stephenangelico/time-on-target/Diagrams/Time_On_Target_Diagram.png

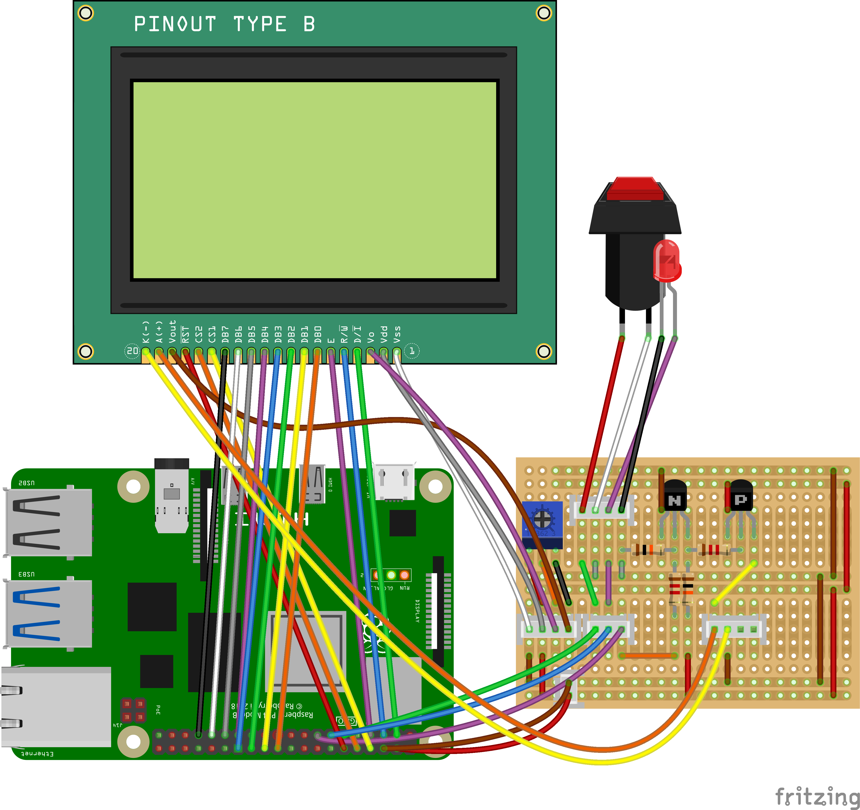
Diagrams/Time_On_Target_Diagram.png
