stephenangelico/time-on-target/Diagrams/Time_On_Target_Schematic.png

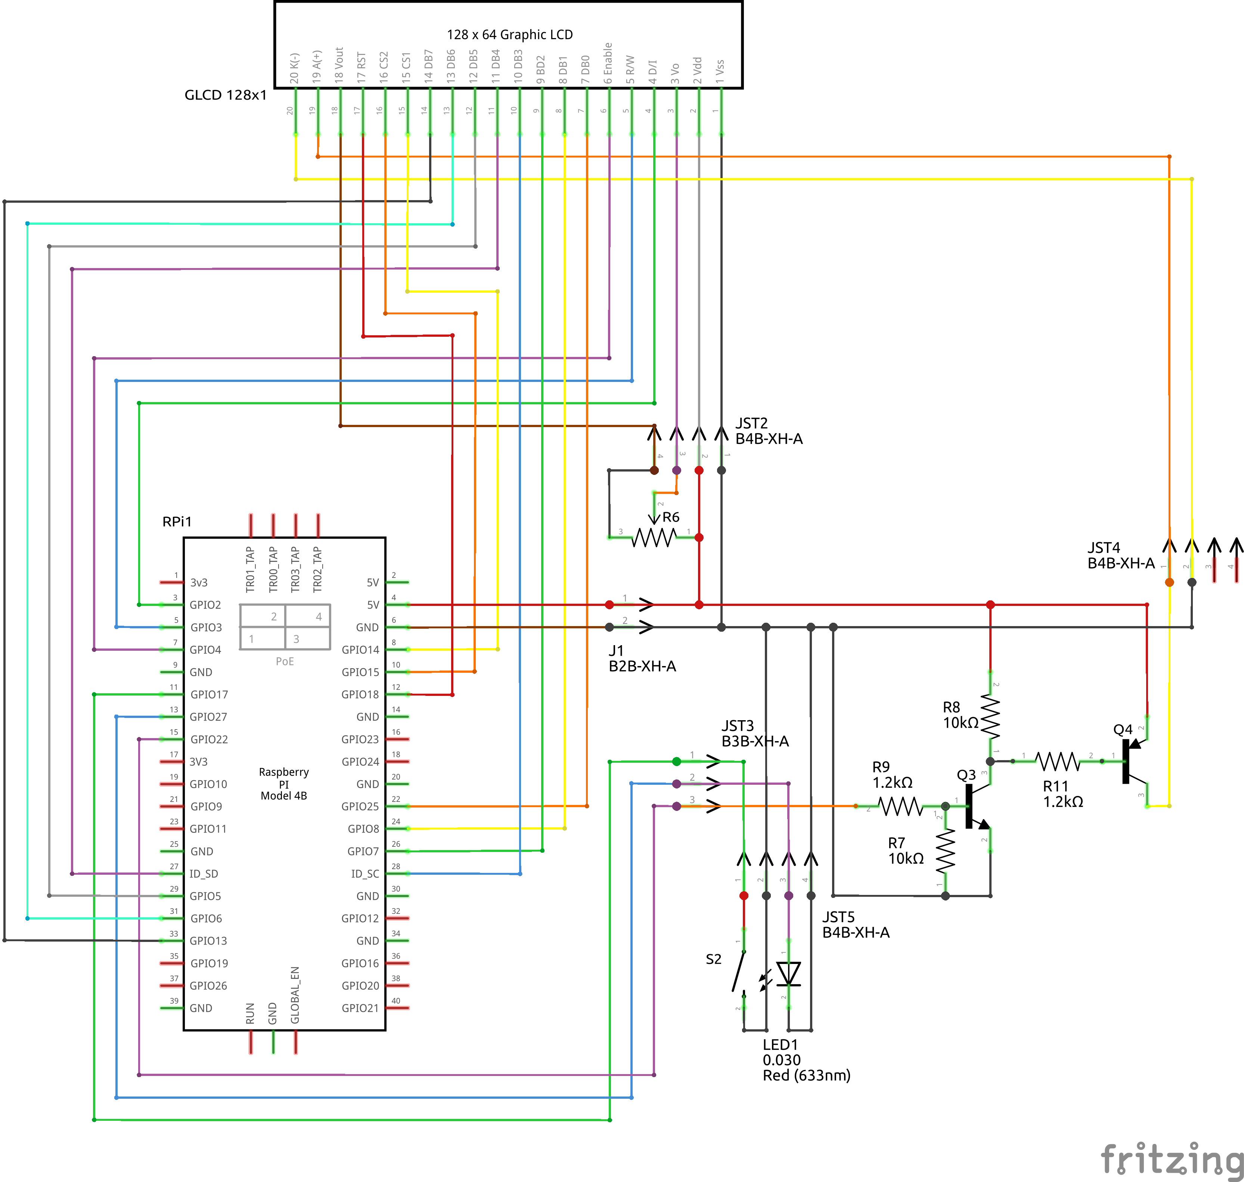
Diagrams/Time_On_Target_Schematic.png
