stephenangelico/time-on-target/Diagrams/TOT_Diagram.png

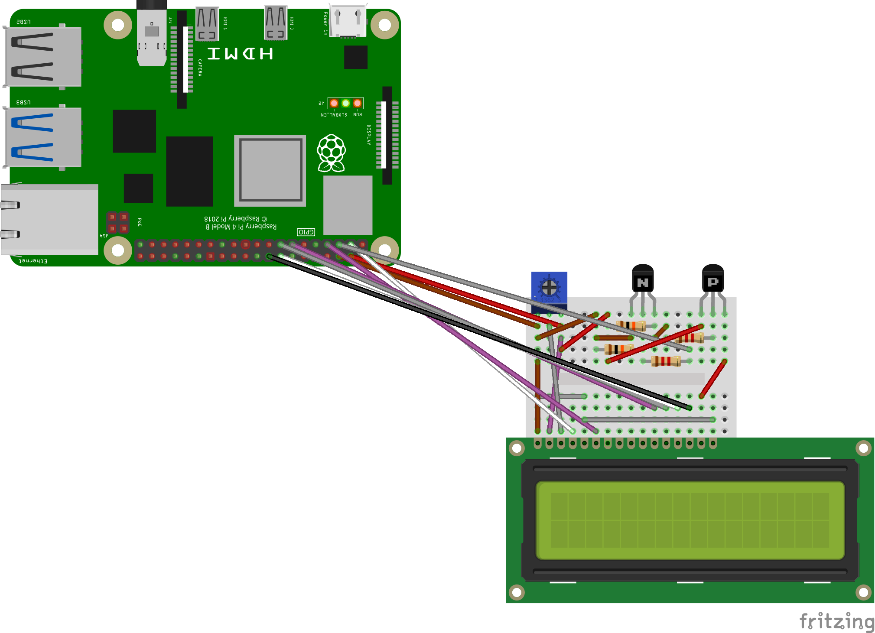
Diagrams/TOT_Diagram.png
