stephenangelico/time-on-target/Diagrams/TOT_Diagram_Matrix_Display.png

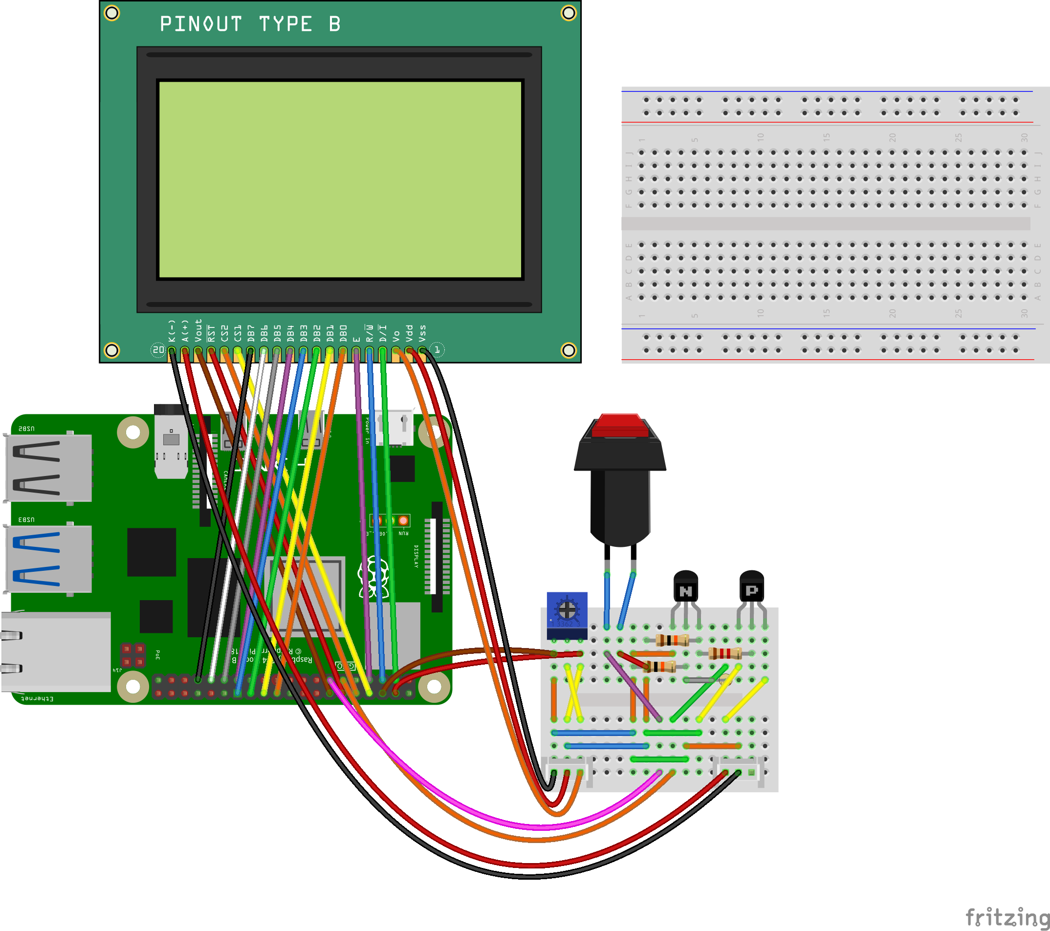
Diagrams/TOT_Diagram_Matrix_Display.png
