stephenangelico/time-on-target/Diagrams/Time_On_Target_Schematic.pdf

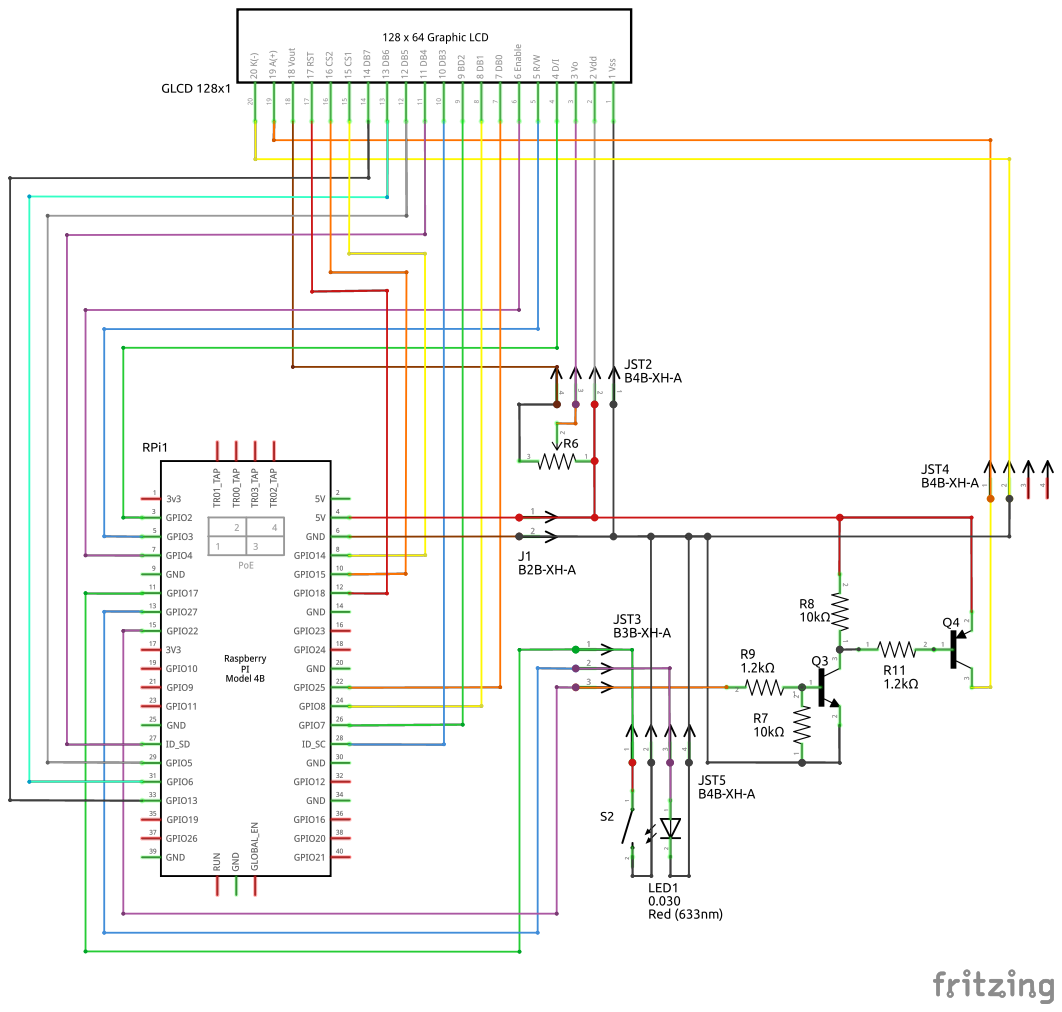
[picture p5: page 1]
