stephenangelico/time-on-target/Diagrams/Matrix_Display_schematic.pdf

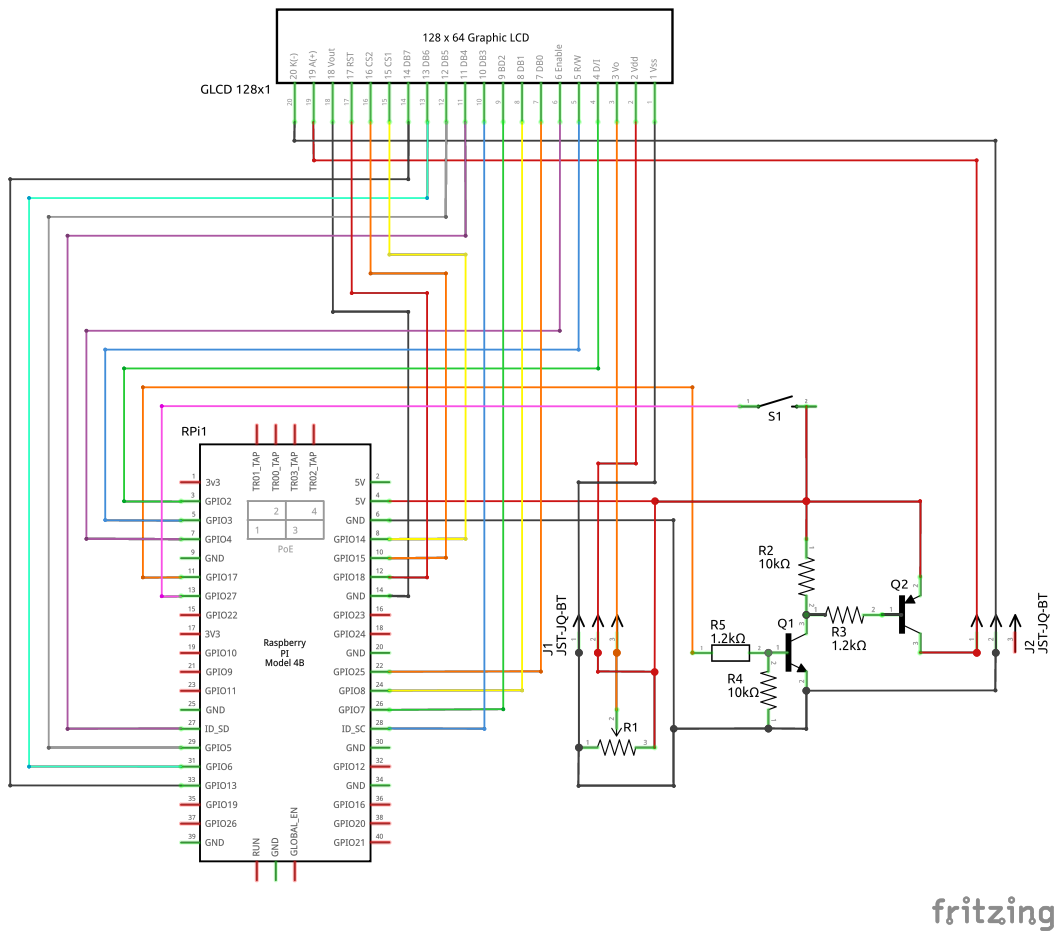
[picture p6: page 1]
