stephenangelico/time-on-target/Diagrams/Time_On_Target_Diagram.pdf

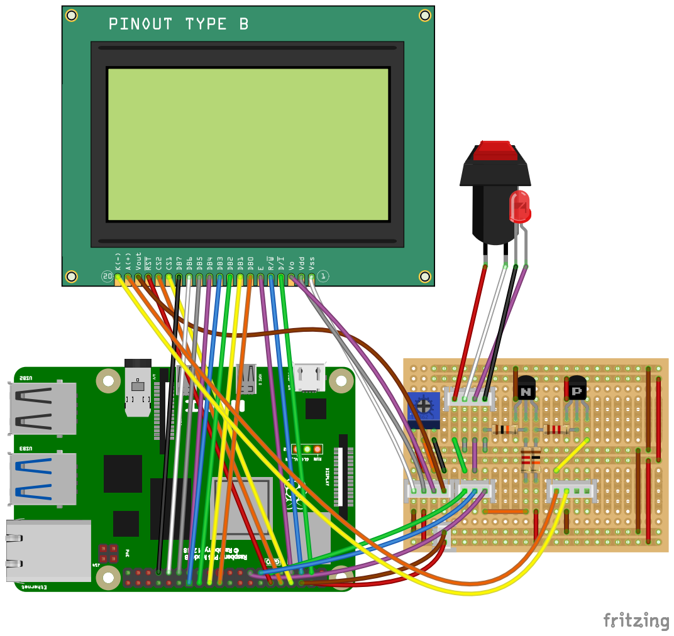
[picture p7: page 1]
