stephenangelico/time-on-target/(list of files, drawings)

Other design files:
Diagrams/LCD_Wiring.fz
Diagrams/LCD_Wiring_Matrix_Display.fz
Diagrams/Old/LCD_Wiring.fz
