stephenangelico/time-on-target/matrix_lcd.py

# Matrix LCD test/library
import time
from enum import IntEnum
import RPi.GPIO as GPIO
import font_small
import font_large
import font_big

# Pin GPIO numbers
class Pin(IntEnum):
	RS = 2 # Register Select or Data/Instruction
	RW = 3 # Read/Write
	EN = 4 # Enable (pulsed only)
	DB0 = 25 # Data bit 0
	DB1 = 8  # Data bit 1
	DB2 = 7  # Data bit 2
	DB3 = 1  # Data bit 3
	DB4 = 0  # Data bit 4
	DB5 = 5  # Data bit 5
	DB6 = 6  # Data bit 6
	DB7 = 13 # Data bit 7
	CS1 = 14 # Column Select 1 (columns 1-64)
	CS2 = 15 # Column Select 2 (columns 65-128)
	RST = 18 # Reset

data_pins = (Pin.DB7, Pin.DB6, Pin.DB5, Pin.DB4, Pin.DB3, Pin.DB2, Pin.DB1, Pin.DB0)
data_state = [None] * len(data_pins)

# Display buffer - 64 rows (arrays) of 128 pixels
def clear_display():
	display[:] = [[0] * 128 for _ in range(64)]
display = []; clear_display()

def set_pixel(row, col, state):
	if 0 <= row < len(display) and 0 <= col < len(display[0]):
		display[row][col] = state

def set_cs(chip):
	GPIO.output(Pin.CS1, chip == 1 or chip == 3)
	GPIO.output(Pin.CS2, chip == 2 or chip == 3)

_chip_select_stack = [3]

class cs:
	def __init__(self, which): self.which = which
	def __enter__(self):
		_chip_select_stack.append(self.which)
		set_cs(self.which)
	def __exit__(self, t,v,tb):
		_chip_select_stack.pop()
		set_cs(_chip_select_stack[-1])

def set_di(mode):
	if mode == "data":
		GPIO.output(Pin.RS, 1)
	elif mode == "inst":
		GPIO.output(Pin.RS, 0)

def set_rw(mode):
	if mode == "read":
		GPIO.output(Pin.RW, 1)
		for pin in data_pins:
			GPIO.setup(pin, GPIO.IN, pull_up_down=GPIO.PUD_DOWN)
	elif mode == "write":
		GPIO.output(Pin.RW, 0)
		for pin in data_pins:
			GPIO.setup(pin, GPIO.OUT)
		data_state[:] = [None] * len(data_pins)

def pulse_enable():
	GPIO.output(Pin.EN, 1)
	#time.sleep(0.000001) # Unnecessary on a Pi - GPIO timing is longer than the 1 usec minimum pulse time
	GPIO.output(Pin.EN, 0)

# Pixels are addressed in vertical segments of 8 pixels.

def set_x(addr):
	# Incrementing X address moves down the display by 8 pixels
	if addr < 0 or addr > 7: raise ValueError("X address must be between 0 and 7 (binary 000 to 111)")
	set_di("inst")
	send_byte(0b10111000 + addr)
	set_di("data")

def set_y(addr):
	# Incrementing Y address moves left by 1 pixel
	if addr < 0 or addr > 63: raise ValueError("Y address must be between 0 and 63 (binary 000000 to 111111)")
	set_di("inst")
	send_byte(0b01000000 + addr)
	set_di("data")

def set_z(addr):
	# Incrementing Z address shifts the entire display up by 1 pixel (with wraparound)
	if addr < 0 or addr > 63: raise ValueError("Z address must be between 0 and 63 (binary 000000 to 111111)")
	set_di("inst")
	send_byte(0b11000000 + addr)
	set_di("data")

def set_output_pin(pin, state):
	"""
	Sets output pins if they are different to their prior state.
	Greatly optimized over naively setting each output regardless of state -
	calling GPIO.output does take an appreciable amount of time when you're doing
	it 8192 times per display blit.
	"""
	if data_state[pin] == state: return # No need to set it to what it already is
	GPIO.output(data_pins[pin], state)
	data_state[pin] = state

def status_read():
	"""
	Read the status of the currently selected segment controller(s)
	Returns Busy, Display and Reset flags from display.LCD module naturally gives
	an OR of status flags, so if both controllers are selected, a high on any flag
	on either chip will be high in the result.
	A result of all zeros indicates everything is good to go. However, the return
	yields all three in case you only care about one flag.
	"""
	set_di("inst")
	set_rw("read") # This sets all data bits to inputs so we can read them
	pulse_enable()
	busy = GPIO.input(Pin.DB7)
	display = GPIO.input(Pin.DB5) # Display bit is 0 for on, 1 for off
	resetting = GPIO.input(Pin.DB4)
	set_rw("write")
	set_di("data")
	return busy, display, resetting

def send_byte(databyte):
	# Send a byte of data/instruction to the display, pulse_enable and wait until no longer busy
	# Note that you must set register select, R/W and column select BEFORE using this function.
	for pin, state in enumerate(f"{databyte:08b}"):
		set_output_pin(pin, state == "1")
		# Byte must be given in binary. Bits are stringified and zipped with data pins
		# For any pin, if state is the string "0", comparing against the string "1"
		# will be false and thus set the pin state to low.
	pulse_enable()

def fill(databyte):
	"""Fill the screen with the given pattern"""
	with cs(3):
		set_y(0)
		for i in range(8):
			set_x(i)
			send_byte(databyte)
			for n in range(63): # Because we already did one
				pulse_enable()
		set_x(0)

def draw_text(x, y, text, *, font=font_small):
	"""Draw text with its baseline starting at (x,y)"""
	# X and Y positions here refer to cartesian coordinates, as distinct from the mode used by the
	# display for addressing.
	rows = display[y - font.ASCENDER - font.BASE + 1 : y + font.DESCENDER + 1]
	# Rows aren't a convenient 8 pixels aligning with display X addresses, we need more height
	# so we define our own rows.
	for char in text:
		try:
			glyph = font.FONT[char]
			# Render character from global font
		except KeyError:
			# Fallback modes
			try:
				glyph = font.FONT[char.upper()]
			except KeyError:
				glyph = font.FONT[" "]
		for row, pixels in zip(rows, glyph):
			# Updating row which is in rows[] directly updates the display buffer
			for i, ch in enumerate(pixels):
				if x + i >= len(row):
					break # Protect against address range overrun
				row[x + i] = ch != " "
				# If the glyph has something in that pixel, it's high, if blank it's low
		x += len(glyph[0]) + font.LETTERSPACING
		# Width of character (character is a list of rows - len(glyph) would be height)

def ellipse(inner, outer):
	for r, row in enumerate(display):
		for c in range(len(row)):
			d = (r-32) ** 2 + (c/2-32)**2
			row[c] = inner < d < outer

def ticking_clock():
	while True:
		t = time.monotonic()
		draw_text(0, 6, time.strftime("%H:%M:%S"))
		# Row = ASCENDER + BASE -1 (zero-base address)
		update()
		time.sleep(0.5 - time.monotonic() + t)

def update():
	set_y(0) # Allow autoincrement to take us all the way
	for r in range(0, len(display), 8):
		set_x(r >> 3) # Assumed to be in cs(3)
		for chip in (1, 2):
			with cs(chip):
				base = 64 if chip == 2 else 0
				for c in range(64):
					for i in range(8):
						set_output_pin(i, display[r+7-i][base + c])
					pulse_enable()

def init():
	GPIO.setmode(GPIO.BCM)
	GPIO.setwarnings(False)
	for pin in Pin:
		GPIO.setup(pin, GPIO.OUT, initial=GPIO.LOW)
	GPIO.output(Pin.RST, 1)
	set_cs(_chip_select_stack[-1]) # First time setting CS - use context manager hereafter
	while "still booting":
		ready_state = status_read()
		if not ready_state[2]:
			break
		else:
			time.sleep(0.0001) # Longer than the 60usec max busy time
	set_di("inst")
	set_rw("write")
	send_byte(0b00111111) # Display on
	set_z(0)
	fill(0b00000000) # Clear screen

def cleanup():
	# TODO: add PWM when circuitry is working again
	fill(0b00000000)
	GPIO.cleanup()

if __name__ == "__main__":
	init()
	#for _ in range(5):
	#	ellipse(800, 900)
	#	update()
	#	time.sleep(0.5)
	#	ellipse(700, 800)
	#	update()
	#	time.sleep(0.5)
	#draw_text(0, 6, input("Enter some text: "))
	#draw_text(0, 6 + font_small.ADVANCEMENT, input("Enter some text: "))
	#update()
	#time.sleep(3)
	try:
		ticking_clock()
	except KeyboardInterrupt:
		pass
	finally:
		cleanup()
