stephenangelico/time-on-target/font_small.py

# Broken out into its own file since these will be fairly large

ASCENDER = 3
BASE = 4
DESCENDER = 3
LEADING = 1 # Note: This is not how far it leads (pron leed) but how much lead is used (pron ledd).
LINEHEIGHT = ASCENDER + BASE + DESCENDER
ADVANCEMENT = LINEHEIGHT + LEADING
LETTERSPACING = 1 # Pixels between characters horizontally

# NOTE: Any non-space character will make the pixel active. The width of the first row will determine
# the width of the character (others should all match).

FONT = {
	" ": ["     "] * 7, # Critical - without this for unknown characters, everything will bomb
	"I": ["X"] * 7, # Special case: Narrow the I. If you don't want this, make it "  X  " instead.
	":": [ # Slightly narrower than digits
		"    ",
		"    ",
		" XX ",
		" XX ",
		"    ",
		" XX ",
		" XX ",
	],
	".": [
		"    ",
		"    ",
		"    ",
		"    ",
		"    ",
		" XX ",
		" XX ",
	],
	"/": [
		"      X",
		"     X ",
		"    X  ",
		"   X   ",
		"  X    ",
		" X     ",
		"X      ",
	],
}

def _make_font(template):
	letters, *rows = template.split("\n")
	for i, ltr in enumerate(letters):
		FONT[ltr] = [row[i*6:i*6+5] for row in rows]
_make_font("""ABCDEFGHJKLMNOPQRSTUVWXYZ
  X   XXXX   XXX  XXXX  XXXXX XXXXX  XXX  X   X     X X   X X     X   X X   X  XXX  XXXX   XXX  XXXX   XXX  XXXXX X   X X   X X   X X   X X   X XXXXX
 X X  X   X X   X X   X X     X     X   X X   X     X X  X  X     XX XX X   X X   X X   X X   X X   X X   X   X   X   X X   X X   X X   X X   X     X
X   X X   X X     X   X X     X     X     X   X     X X X   X     X X X XX  X X   X X   X X   X X   X X       X   X   X X   X X   X  X X   X X     X 
XXXXX XXXX  X     X   X XXXX  XXXX  X     XXXXX     X XX    X     X   X X X X X   X XXXX  X   X XXXX   XXX    X   X   X X   X X   X   X     X     X  
X   X X   X X     X   X X     X     X  XX X   X     X X X   X     X   X X  XX X   X X     X   X X X       X   X   X   X X   X X X X  X X    X    X   
X   X X   X X   X X   X X     X     X   X X   X X   X X  X  X     X   X X   X X   X X     X X X X  X  X   X   X   X   X  X X   X X  X   X   X   X    
X   X XXXX   XXX  XXXX  XXXXX X      XXX  X   X  XXX  X   X XXXXX X   X X   X  XXX  X      XXXX X   X  XXX    X    XXX    X    X X  X   X   X   XXXXX
                                                                                              X                                                      """)
# NOTE: Keep the digits all at max width, even if they don't all use it. This
# keeps the display stable during ticking.
_make_font("""0123456789
 XXX    X    XXX   XXX     X  XXXXX  XXX  XXXXX  XXX   XXX 
X   X  XX   X   X X   X   XX  X     X   X     X X   X X   X
X  XX   X      X      X  X X  X     X         X X   X X   X
X X X   X     X    XXX  X  X  XXXX  XXXX     X   XXX   XXXX
XX  X   X    X        X XXXXX     X X   X    X  X   X     X
X   X   X   X     X   X    X  X   X X   X   X   X   X     X
 XXX   XXX  XXXXX  XXX     X   XXX   XXX    X    XXX      X""")
_make_font("""()[]!?
   X   X     XXX   XXX    X    XXX 
  X     X    X       X    X   X   X
 X       X   X       X    X       X 
 X       X   X       X    X      X 
 X       X   X       X    X     X  
  X     X    X       X             
   X   X     XXX   XXX    X     X  """)
