stephenangelico/time-on-target/(commit log)

2024-11-23 tot: Fix lcd.clear() call
    [tot.py]
2024-11-23 tot: Fix GPIO import
    [tot.py]
2024-11-23 tot: Fix message sending - assignment not method call
    [tot.py]
2024-12-21 tot: Re-enable backlight as soft PWM
2025-01-04 Add Fritzing files for wiring - so far only LCD and backlight circuitry
    [LCD_Wiring.fz]
2025-01-18 tot: Swap from using GPIO. PWM to pwmio (understood by adafruit_character_lcd)
    [tot.py]
2025-01-18 tot: Make the dummy backlight pins PWM as well
2025-01-18 tot: Revert to GPIO PWM - wiring is incompatible with pwmio
    [tot.py]
2025-02-01 tot: Add other fourth line modes and marquee if too long
    [tot.py]
2025-02-08 tot: Use threading to keep asyncio and lcd stuff separate
    Adafruit-CharLCD uses synchronous time.sleep internally, leading to jumping and
    other timing issues when running in an event loop
    [tot.py]
2025-02-08 tot: Render to LCD now that the threading test was successful
2025-02-15 tot: Fix order of pwm stuff in cleanup (derp)
    [tot.py]
2025-03-08 README: Added hardware and wiring plan - display is now 128x64 matrix
    The character LCD was too limiting - a multi-line font could not be made to look
    good enough with the extremely limited custom character support (8 is not many).
    A new display has been acquired which is wired very similarly to the character
    LCD, but is a graphical matrix display. This will require some changes to wiring
    and a lot of changes to code - most likely a new Python/asyncio driver.
2025-04-05 Add Fritzing diagram for new version using matrix LCD
    [LCD_Wiring_Matrix_Display.fz]
2025-04-12 Diagrams: Add schematic wire routing, add button, archive old diagrams
    [LCD_Wiring.fz, LCD_Wiring_Matrix_Display.fz]
2025-04-26 Diagrams: Add circuit design for printed stripboard version
    [LCD_Wiring_Matrix_Display.fz]
2025-05-17 tot: Add note about using button in pull-up mode
2025-05-17 Diagrams: Set button to use pull-up mode - incompatible with temp breadboard
    [LCD_Wiring_Matrix_Display.fz]
2025-05-24 Diagrams: Route schematic for stripboard to confirm circuit equivalence
    [LCD_Wiring_Matrix_Display.fz]
2025-05-24 README: Fix wiring references for button connections
2025-05-31 Diagrams: Add stripboard to show how wire links will be connected
    [LCD_Wiring_Matrix_Display.fz]
2025-06-28 Diagrams: Fix wire positions on stripboard
    [LCD_Wiring_Matrix_Display.fz]
2025-08-16 Diagrams: Fix 5V/GND to J3 (LCD power) - caused actual short-circuit!
    [LCD_Wiring_Matrix_Display.fz]
2025-08-30 Diagrams: Fix order of control wires
    [LCD_Wiring_Matrix_Display.fz]
2025-09-20 Diagrams: Update main stripboard with correct model and better wiring of trimpot
    [LCD_Wiring_Matrix_Display.fz]
2025-11-01 Diagrams: Re-add 2-pin JST after tweaking and re-importing
    [LCD_Wiring_Matrix_Display.fz]
2025-11-29 Diagrams: Remove old breadboard and reroute everything in stripboard
    [LCD_Wiring_Matrix_Display.fz]
2025-11-29 README: Complete diagrams TODO and update wiring list
2025-12-20 README: Remove next stream notes (done) and add note for using button
2026-01-02 matrix_lcd: Fix missing colons after else statements
    [matrix_lcd.py]
2026-01-17 matrix_lcd: Flip data and instruction because RTFM (derp)
    [matrix_lcd.py]
2026-01-17 matrix_lcd: Revert 6b685e (set_cs()) but keep pulse_enable() from b38096
    [matrix_lcd.py]
2026-01-24 matrix_lcd: Add context manager for chip select, and fix off-by-one in cls()
    [matrix_lcd.py]
2026-01-31 matrix_lcd: Remove reference to Arduino example code - fully implemented
2026-01-31 matrix_lcd: Use pull-down resistor when in read mode (prevent floating bits)
    [matrix_lcd.py]
2026-01-31 matrix_lcd: Fix references to circle() - now ellipse()
    [matrix_lcd.py]
2026-02-07 matrix_lcd: No longer breaching encapsulation - remove warning comment
    [matrix_lcd.py]
2026-02-07 matrix_lcd: Fix ref to constant in font_small
    [matrix_lcd.py]
2026-02-07 matrix_lcd: Fix time jumping by "sleep rest of" instead of normal sleep
    [matrix_lcd.py]
2026-02-14 requirements: Switch to Google-specific HTTP and OAuth clients (HTTP is dep)
2026-02-14 gcal: Add stub of Google Calendar library with basic authentication flow
2026-02-28 gcal: Fix token handling (basically follow Google's example code)
    [gcal.py]
2026-03-06 gcal: Re-auth if refreshing token fails
    [gcal.py]
2026-03-06 gcal: Add cleaner error message when re-auth is required
    [gcal.py]
2026-03-07 gcal: Return alarms rather than printing them
2026-03-20 tot: Spin up thread for cal_sync
2026-03-20 tot: Clear display buffer before rendering text to avoid overwrite
    [tot.py]
2026-03-27 gcal: Print something if run alone, just to show that something worked
2026-03-27 tot: Clean up delta brackets and actually use the tag
2026-03-28 font_small: Make / wider to prevent untidy aliasing
    [font_small.py]
2026-03-28 tot: Add stubs of alarm ringer and button listener functions
2026-04-11 tot: Fix error handling when not on Pi
    [tot.py]
2026-04-25 tot: Fix syntax error when catching ImportError
    [tot.py]
2026-04-25 README: Add Dependencies section
    RPi.GPIO is no longer compatible with modern Raspberry Pi OS as it comes with
    lgpio, a new API-based system for accessing GPIO. There is now a shim to provide
    a similar interface while using the new API, which can be installed via APT or
    PyPI. So far, both APT and PyPI have the same version, but if that changes, the
    installation method may also change.
2026-04-25 tot: Add test callbacks for button listener
2026-05-16 tot: Add time to button printout for debounce testing
2026-05-16 tot: Interpret button actions (rise/fall) as short or long presses
    [tot.py]
2026-05-16 tot: Display latest button press on LCD
2026-05-16 tot: Enable the button by default
2026-05-23 tot: Add signal to immediately update display (eg on button press)
2026-05-23 tot: Use button to cancel currently displayed alarm
2026-05-23 tot: Fix missing alarm state
    [tot.py]
2026-05-30 tot: Fix cal_sync overwriting timeout with later or cancelled events
    [tot.py]
2026-05-30 tot: Fix alarm ringer and signal
    [tot.py]
2026-06-06 tot: Rename current_alarm to disp_alarm (so we can use current_alarm elsewhere)
2026-06-06 tot: Display current alarm if it is ringing
2026-06-06 tot: Fix passing current alarm to ringer
    [tot.py]
2026-06-06 tot: Fix current alarm being passed as tuple rather than single object
    [tot.py]
2026-06-06 matrix_lcd: Fix trying to draw text outside of display
    [matrix_lcd.py]
2026-06-13 tot: Fix address of overdraw test (precursor to animation)
    [tot.py]
2026-06-27 tot: Fix frame needing to be an int
    [tot.py]
2026-06-27 tot: Increase framerate during alarms
2026-06-27 Retain pin state to optimize repeated setting
2026-06-27 tot: Tweak animation to be more visible after last commit optimized draw time
    Testing showed that the display update time was a severe bottleneck before the
    previous commit/merge. With a more optimized update(), blitting is now faster
    than the LCD's response time. Framerate has been slowed down and the placeholder
    sprite is larger, making it easier to see on the display.
2026-07-18 tot: Rework animation to draw a chevron (just one until tested)
    [tot.py]
2026-07-25 tot: Fix chevron width off-by-one
    [tot.py]
2026-07-25 tot: Offset phase to prevent chevron collision in centre of display
    [tot.py]
2026-07-25 tot: Fix chevron_scale not being used
    [tot.py]
2026-07-25 tot: Fix off-by-one on chevron height
    [tot.py]
2026-08-01 gcal: Instead of exit on re-auth error (which doesn't work), return empty list
    [gcal.py]
2026-08-08 gcal: Switch to service account authorization - no more token refresh hopefully
2026-08-15 tot: Display errors from gcal on LCD
    [tot.py]
2026-08-15 font_small: Add square brackets
2026-08-15 tot: Split error message across two lines if it's too long
    [tot.py]
2026-08-15 tot: Complete a couple of TODOs
2026-08-15 First cut large font
2026-08-22 matrix_lcd: Fix missing comma in parameters
    [matrix_lcd.py]
2026-08-22 matrix_lcd: Fix last references to character glyph (was called 'font' before)
    [matrix_lcd.py]
2026-09-05 font_big: Fix spacing calculation
    [font_big.py]
2026-09-05 tot: Fix alarm animation being on the wrong lines
    [tot.py]
2026-09-25 Add PWM test to later be added into matrix_lcd as brightness control
2026-09-25 pwm_test: Fix range and add cleanup
    [pwm_test.py]
